cskordis/EFA-datorn-EFA-4-Computer/EFA-4 Ram Slim/BOM/EFA 4 Ram Slim Board.csv

Reference | Value | Footprint | Datasheet | Qty | DNP
C1,C2 | 100nF | Capacitor_THT:C_Disc_D3.0mm_W1.6mm_P2.50mm | ~ | 2
C3 | 47uF | Capacitor_THT:CP_Radial_D5.0mm_P2.50mm | ~ | 1
D1 | POWER | LED_THT:LED_D5.0mm | ~ | 1
J1 | ~ | LocalFP:EFAEdge |  | 1
J2 | Conn_01x03 | Connector_PinHeader_2.54mm:PinHeader_1x03_P2.54mm_Vertical | ~ | 1
R1 | 1K | Resistor_THT:R_Axial_DIN0207_L6.3mm_D2.5mm_P7.62mm_Horizontal | ~ | 1
U1 | 6164/6116 | Package_DIP:DIP-28_W15.24mm | https://www.farnell.com/datasheets/2159.pdf | 1
U2 | 74HC174 | Package_DIP:DIP-16_W7.62mm | http://www.ti.com/lit/gpn/sn74LS174 | 1
U3 | 6164 Slim | Package_DIP:DIP-28_W7.62mm_Socket | https://www.farnell.com/datasheets/2159.pdf | 1
