cskordis/EFA-datorn-EFA-4-Computer/EFA-4 Ram 32K/BOM/EFA 4 Ram 32K Board.csv

Reference | Value | Footprint | Datasheet | Qty | DNP
C1,C2 | 100nF | Capacitor_THT:C_Disc_D3.0mm_W1.6mm_P2.50mm | ~ | 2
C3 | 47uF | Capacitor_THT:CP_Radial_D5.0mm_P2.50mm | ~ | 1
C4 | 22pF | Capacitor_THT:C_Disc_D3.0mm_W1.6mm_P2.50mm | ~ | 1
D1 | POWER | LED_THT:LED_D5.0mm | ~ | 1
J1 | ~ | LocalFP:EFAEdge |  | 1
R1 | 1K | Resistor_THT:R_Axial_DIN0207_L6.3mm_D2.5mm_P7.62mm_Horizontal | ~ | 1
R2 | 22K | Resistor_THT:R_Axial_DIN0207_L6.3mm_D2.5mm_P7.62mm_Horizontal | ~ | 1
U1 | 74LS573 | Package_DIP:DIP-20_W7.62mm | 74xx/74hc573.pdf | 1
U2 | HM62256BLP | Package_DIP:DIP-28_W15.24mm | https://web.mit.edu/6.115/www/document/62256.pdf | 1
