cskordis/EFA-datorn-EFA-4-Computer/EFA-4 Auto Keyer/Images/EFA 4 AutoKeyer Component Side.jpg

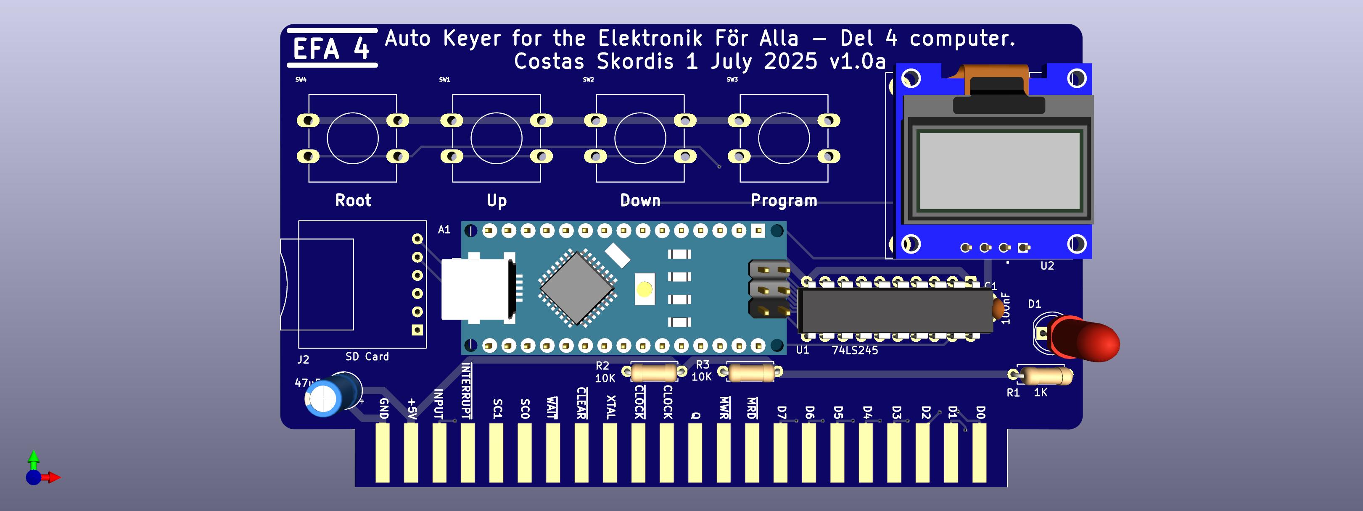
EFA-4 Auto Keyer/Images/EFA 4 AutoKeyer Component Side.jpg
