cskordis/EFA-datorn-EFA-4-Computer/EFA-4 CPU/Images/EFA 4 Component Side.jpg

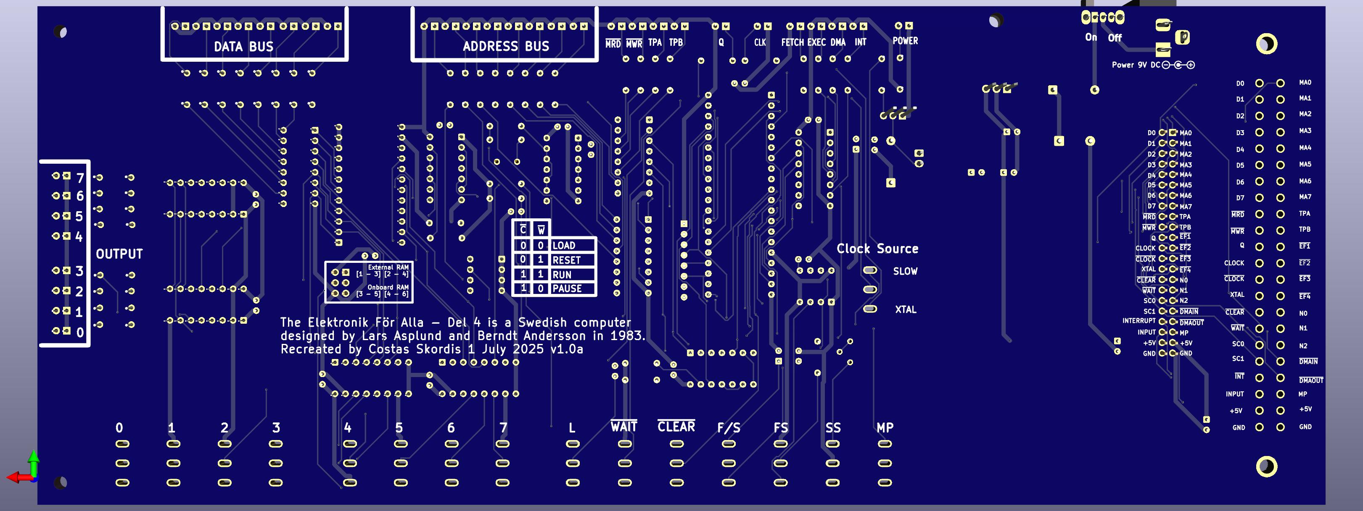
EFA-4 CPU/Images/EFA 4 Component Side.jpg
