cskordis/EFA-datorn-EFA-4-Computer/EFA-4 Hex Display Board/Images/EFA 4 Hex Display Board Component Side.jpg

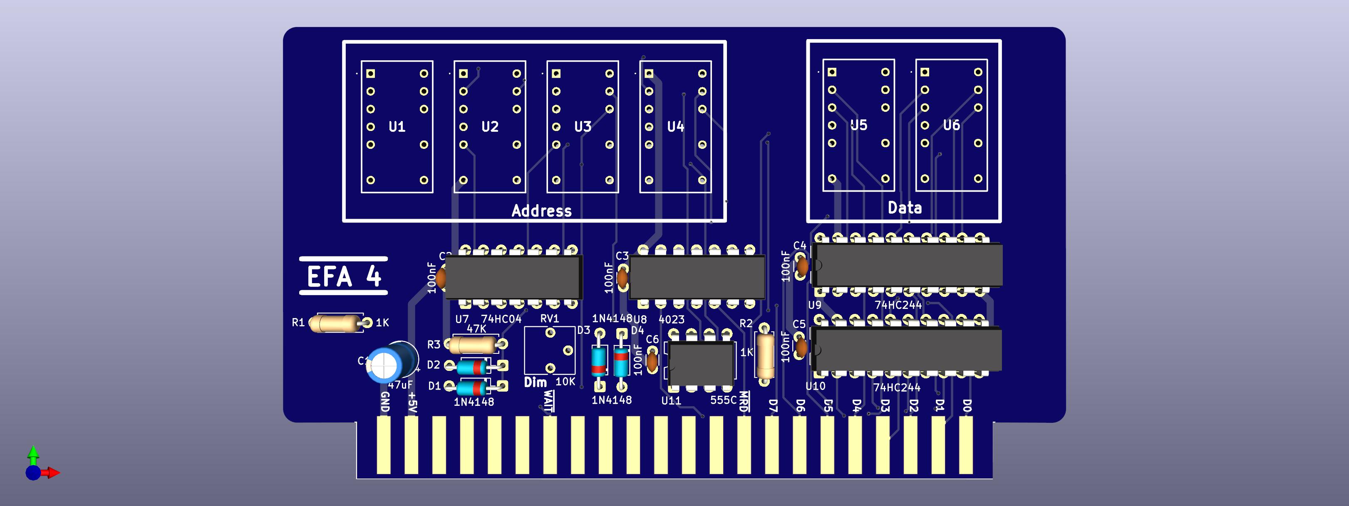
EFA-4 Hex Display Board/Images/EFA 4 Hex Display Board Component Side.jpg
