cskordis/EFA-datorn-EFA-4-Computer/EFA-4 Keypad Input/Images/EFA 4 Keypad Component Side.jpg

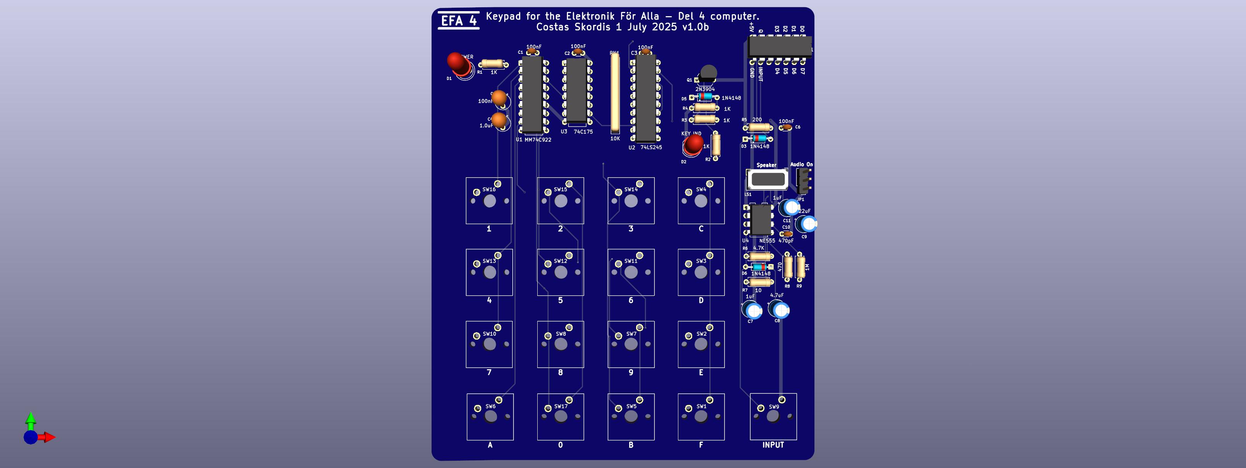
EFA-4 Keypad Input/Images/EFA 4 Keypad Component Side.jpg
