cskordis/EFA-datorn-EFA-4-Computer/EFA-4 Protoboard/Images/EFA 4 Blank Board Component Side.jpg

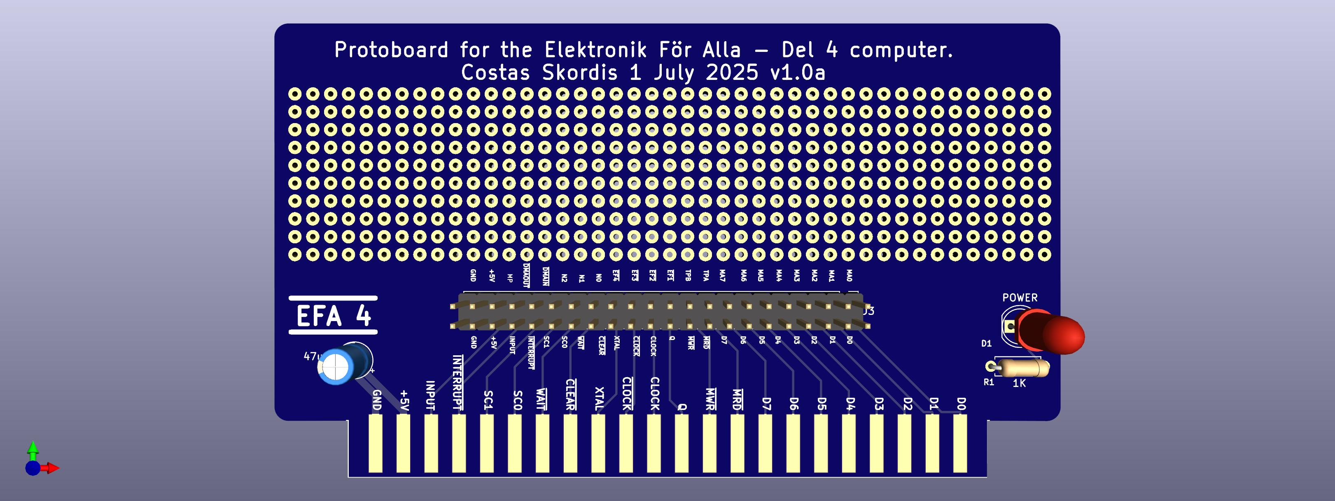
EFA-4 Protoboard/Images/EFA 4 Blank Board Component Side.jpg
