cskordis/EFA-datorn-EFA-4-Computer/EFA-4 Ram 32K/Images/EFA 4 Ram 32K Board Component Side.jpg

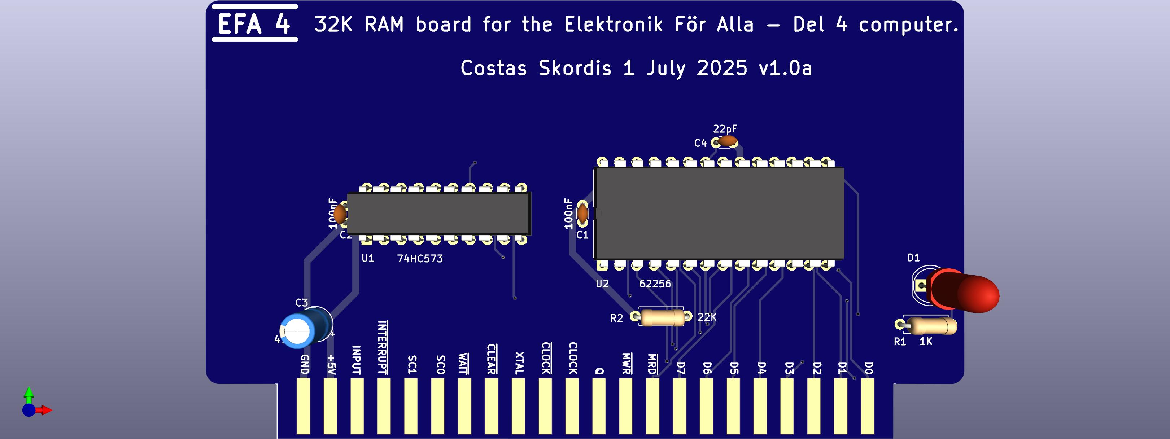
EFA-4 Ram 32K/Images/EFA 4 Ram 32K Board Component Side.jpg
