cskordis/EFA-datorn-EFA-4-Computer/EFA-4 Ram Rom 32K/Images/EFA 4 Ram Rom 32K Board Component Side.jpg

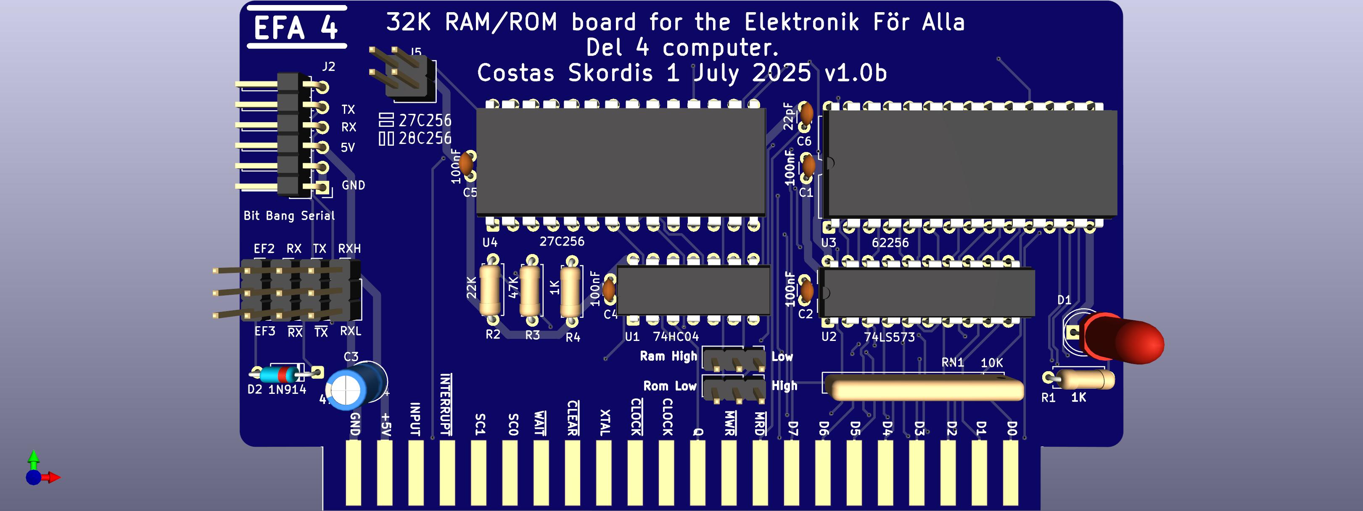
EFA-4 Ram Rom 32K/Images/EFA 4 Ram Rom 32K Board Component Side.jpg
