cskordis/EFA-datorn-EFA-4-Computer/EFA-4 Ram Slim/Images/EFA 4 Ram Slim Board Component Side.jpg

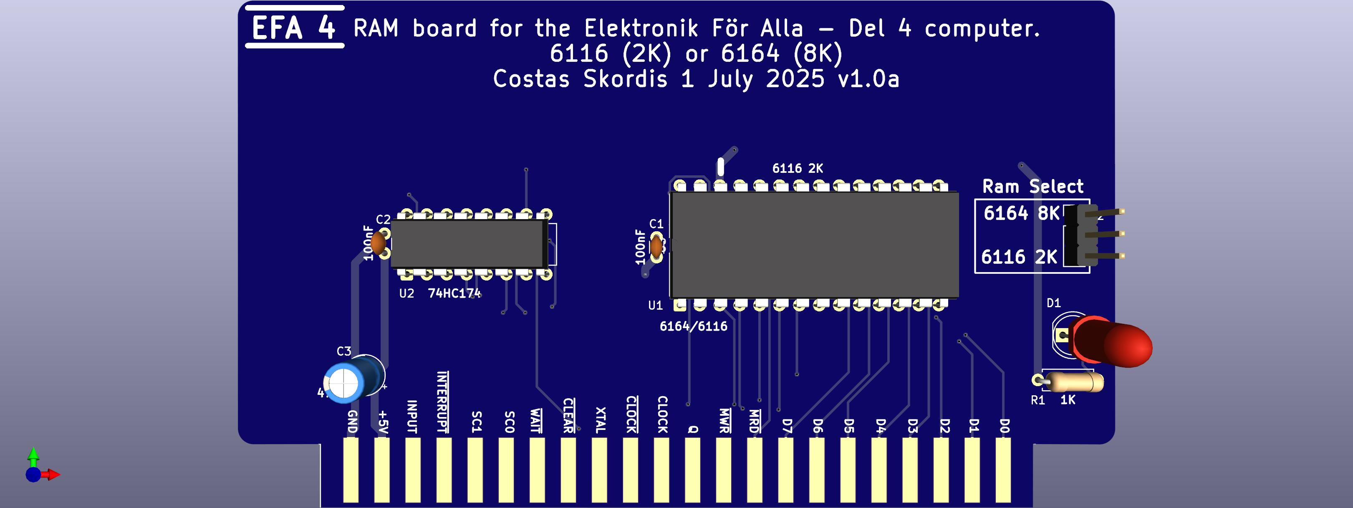
EFA-4 Ram Slim/Images/EFA 4 Ram Slim Board Component Side.jpg
