cskordis/EFA-datorn-EFA-4-Computer/EFA-4 Backplane Board/Images/EFA 4 Backplane Board Solder Side.jpg

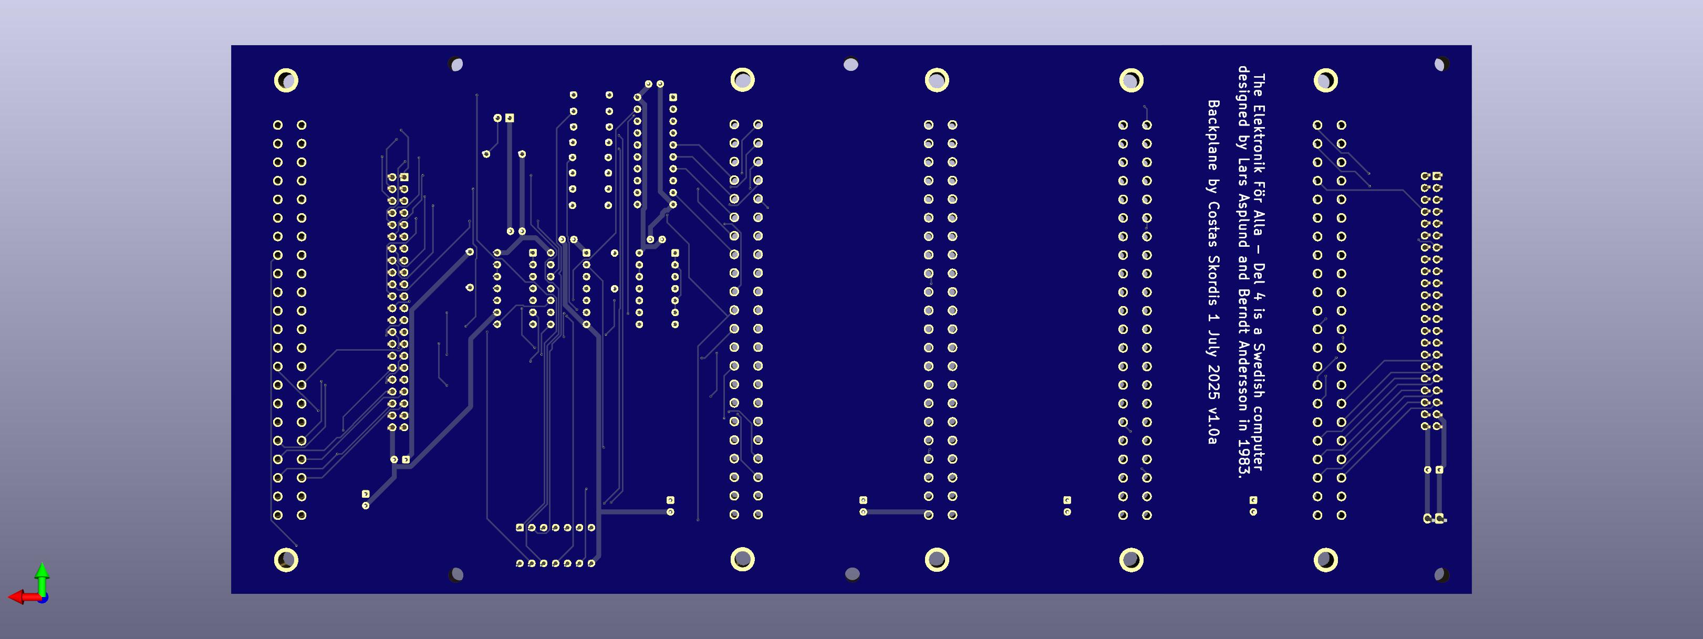
EFA-4 Backplane Board/Images/EFA 4 Backplane Board Solder Side.jpg
