cskordis/EFA-datorn-EFA-4-Computer/EFA-4 Hex Display Board/Images/EFA 4 Hex Display Board Solder Side.jpg

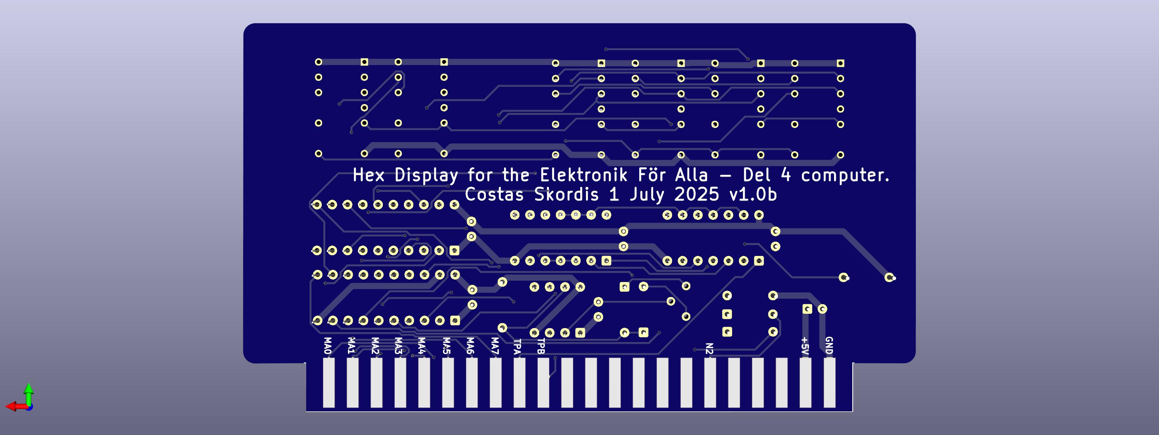
EFA-4 Hex Display Board/Images/EFA 4 Hex Display Board Solder Side.jpg
