cskordis/EFA-datorn-EFA-4-Computer/EFA-4 Pixie/Images/EFA 4 Pixie Board Solder Side.jpg

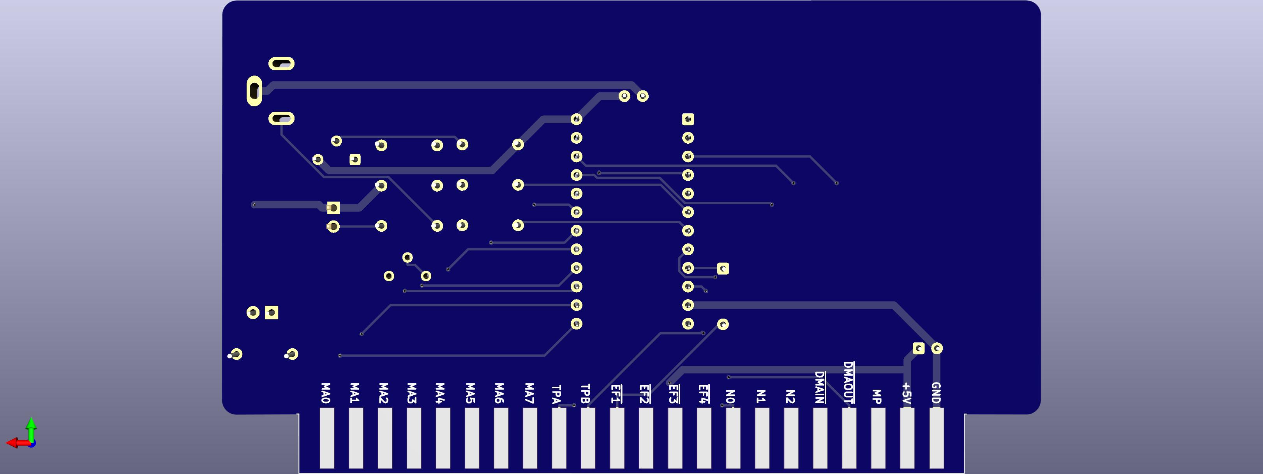
EFA-4 Pixie/Images/EFA 4 Pixie Board Solder Side.jpg
