cskordis/EFA-datorn-EFA-4-Computer/EFA-4 Ram Rom 32K/Images/EFA 4 Ram Rom 32K Board Solder Side.jpg

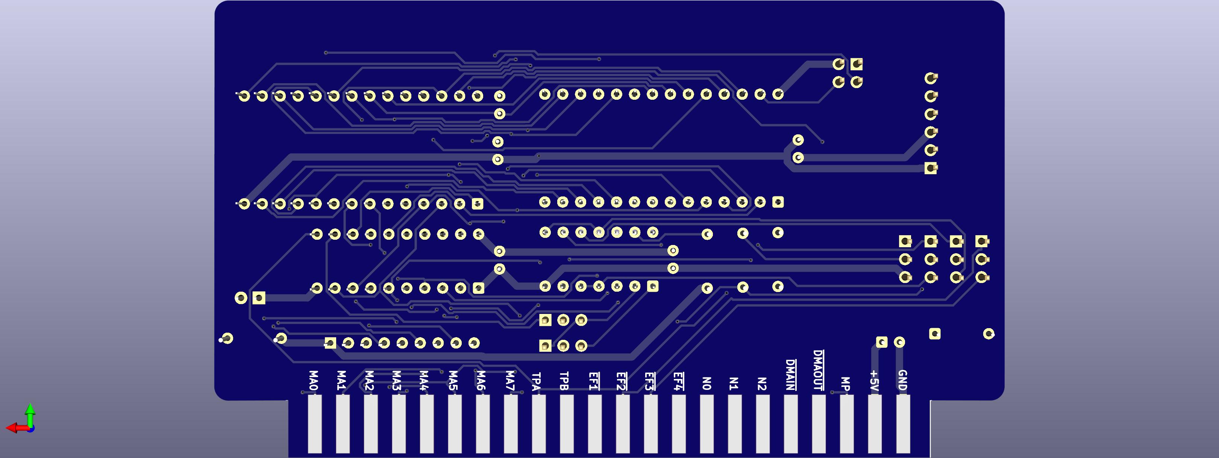
EFA-4 Ram Rom 32K/Images/EFA 4 Ram Rom 32K Board Solder Side.jpg
