cskordis/EFA-datorn-EFA-4-Computer/EFA-4 Ram/Images/EFA 4 Ram Board Solder Side.jpg

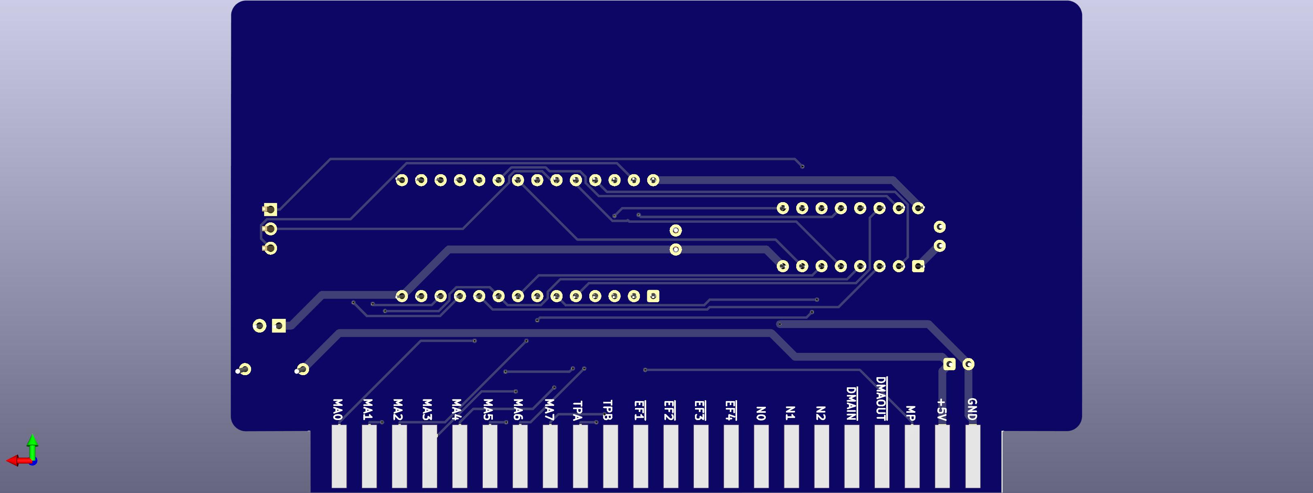
EFA-4 Ram/Images/EFA 4 Ram Board Solder Side.jpg
