cskordis/EFA-datorn-EFA-4-Computer/EFA-4 CPU/Schematic/EFA 4 Schematic.pdf

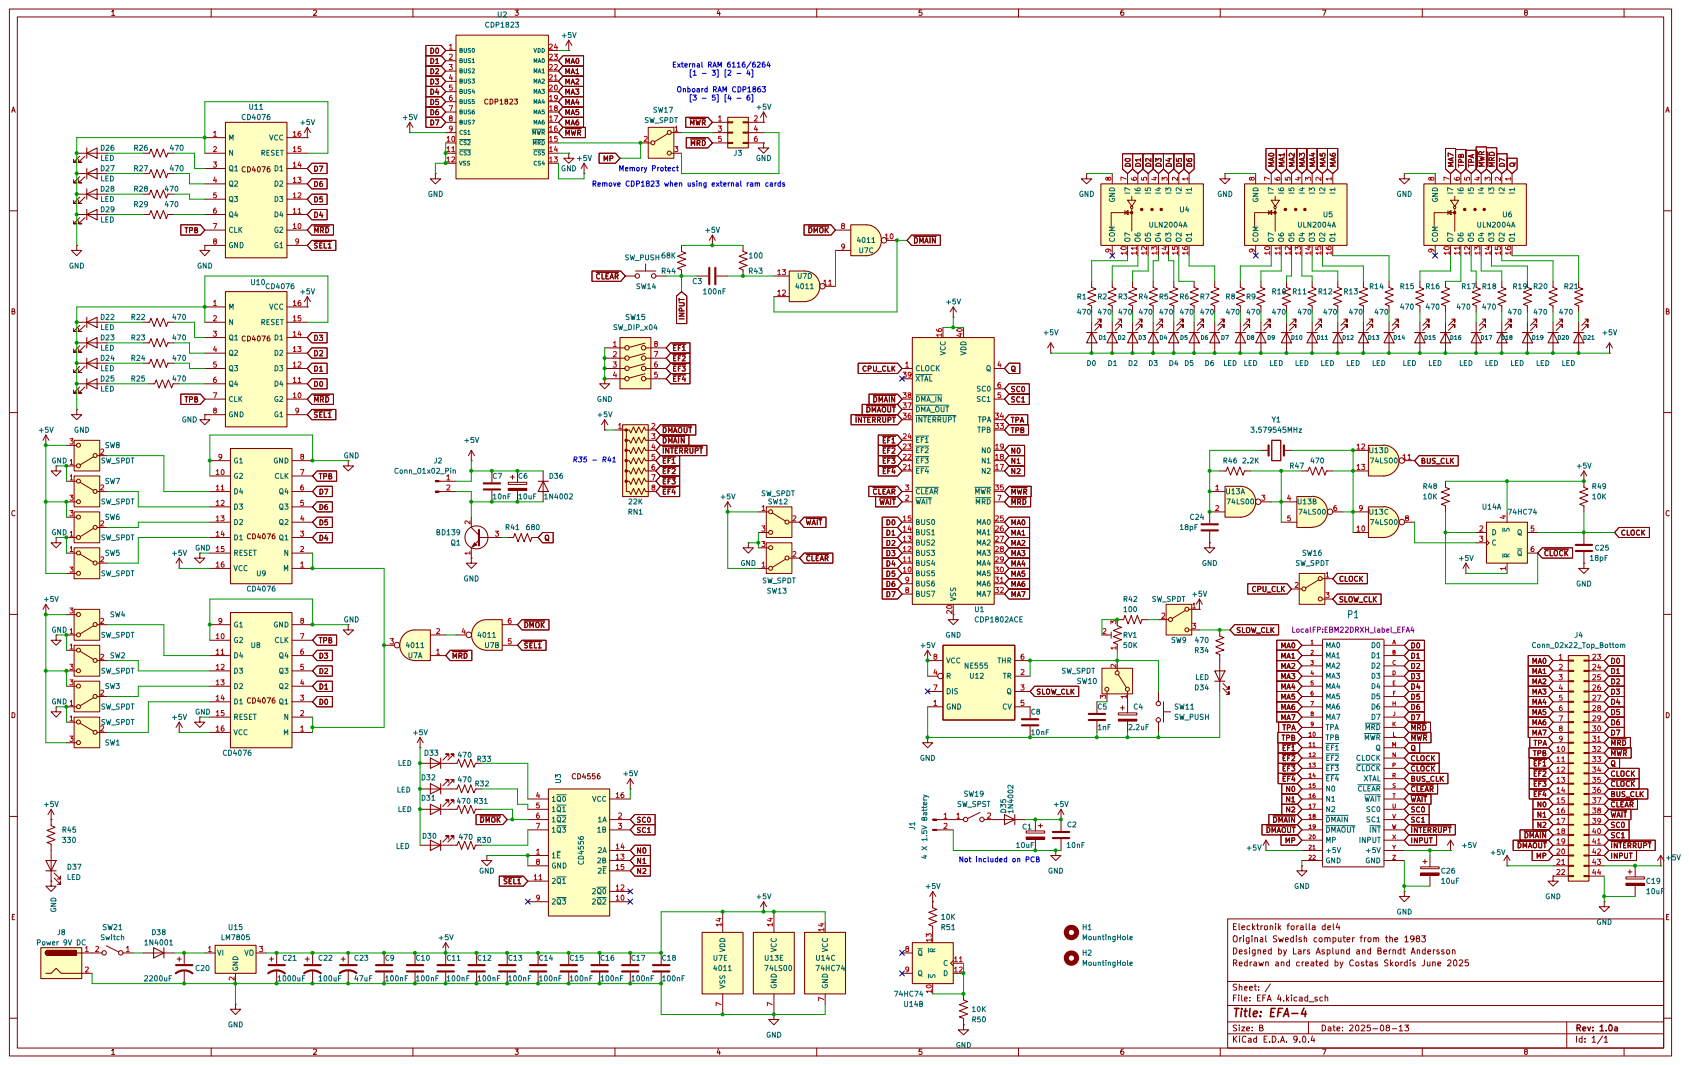
[picture p20: page 1]
