cskordis/EFA-datorn-EFA-4-Computer/EFA-4 Hex Display Board/Schematic/EFA 4 Hex Display Board Schematic.pdf

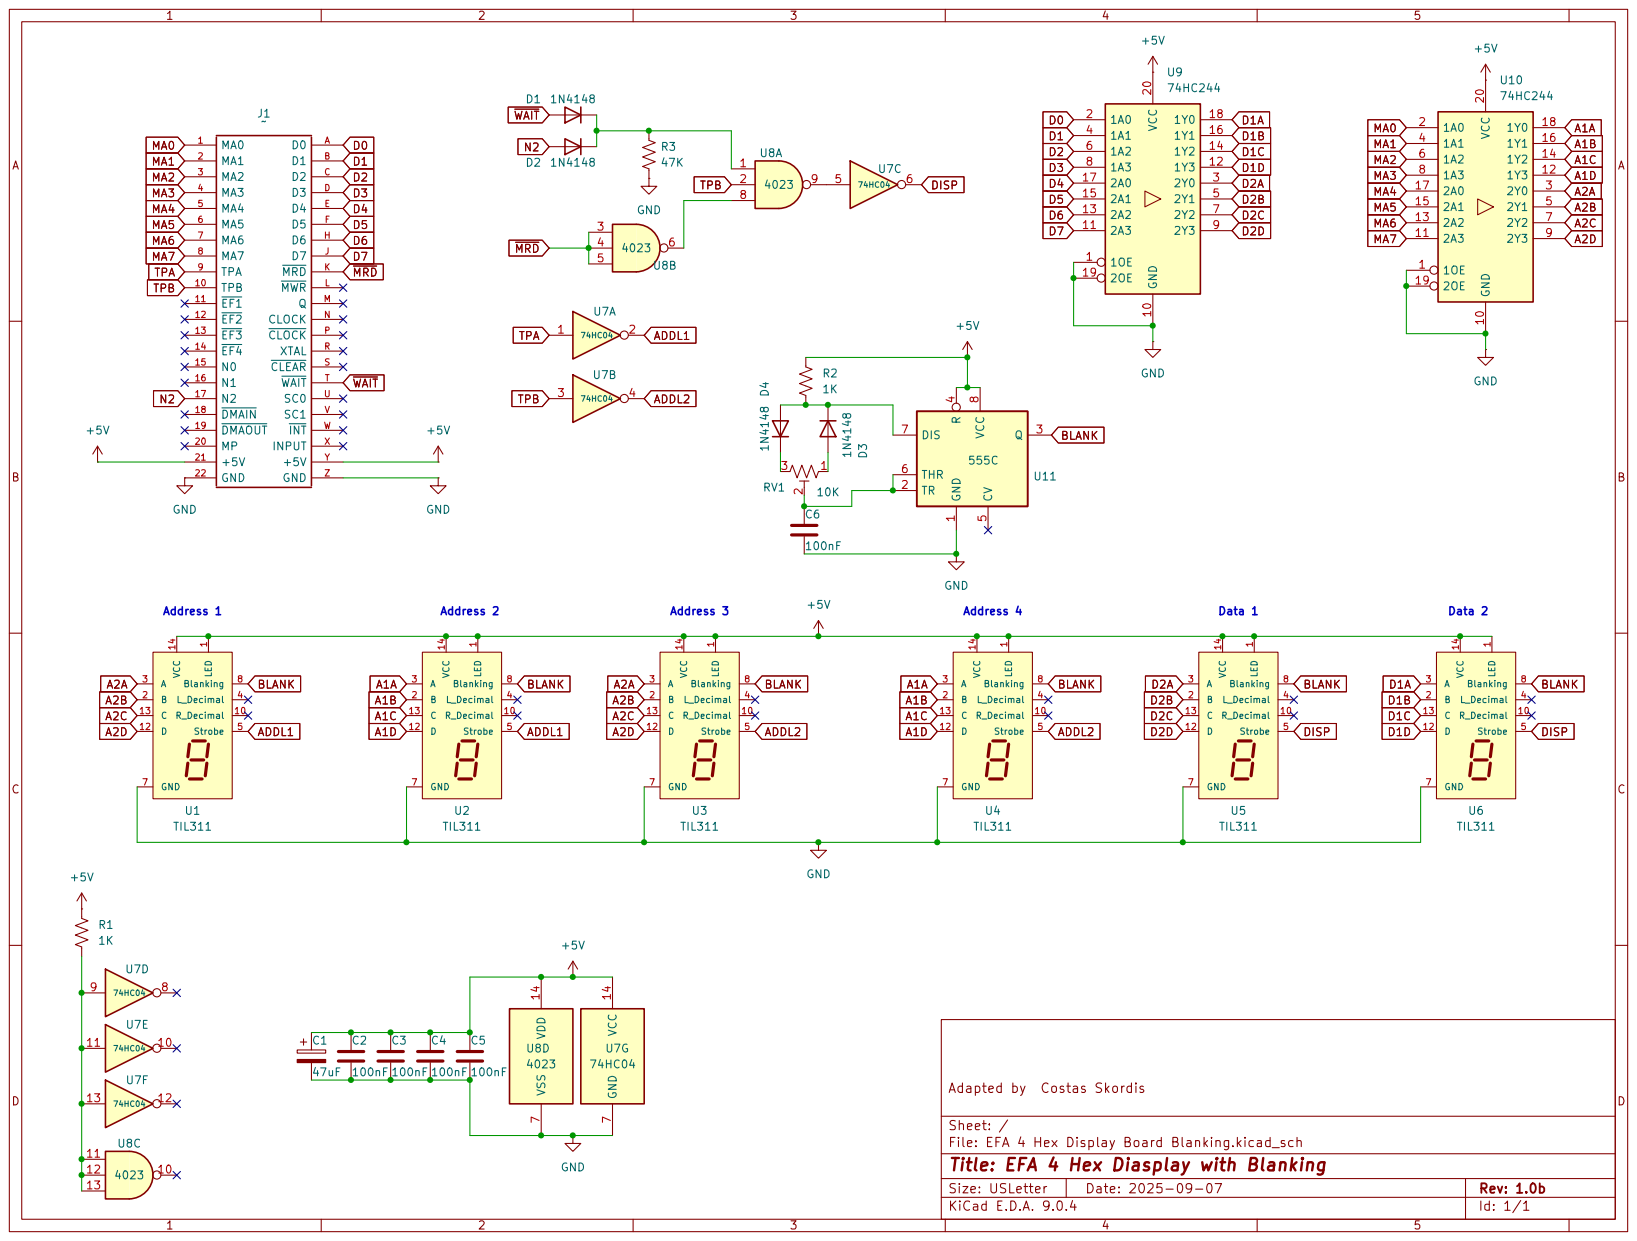
[picture p21: page 1]
