cskordis/EFA-datorn-EFA-4-Computer/EFA-4 Keypad Input/Schematic/EFA 4 Keypad Input Schematic.pdf

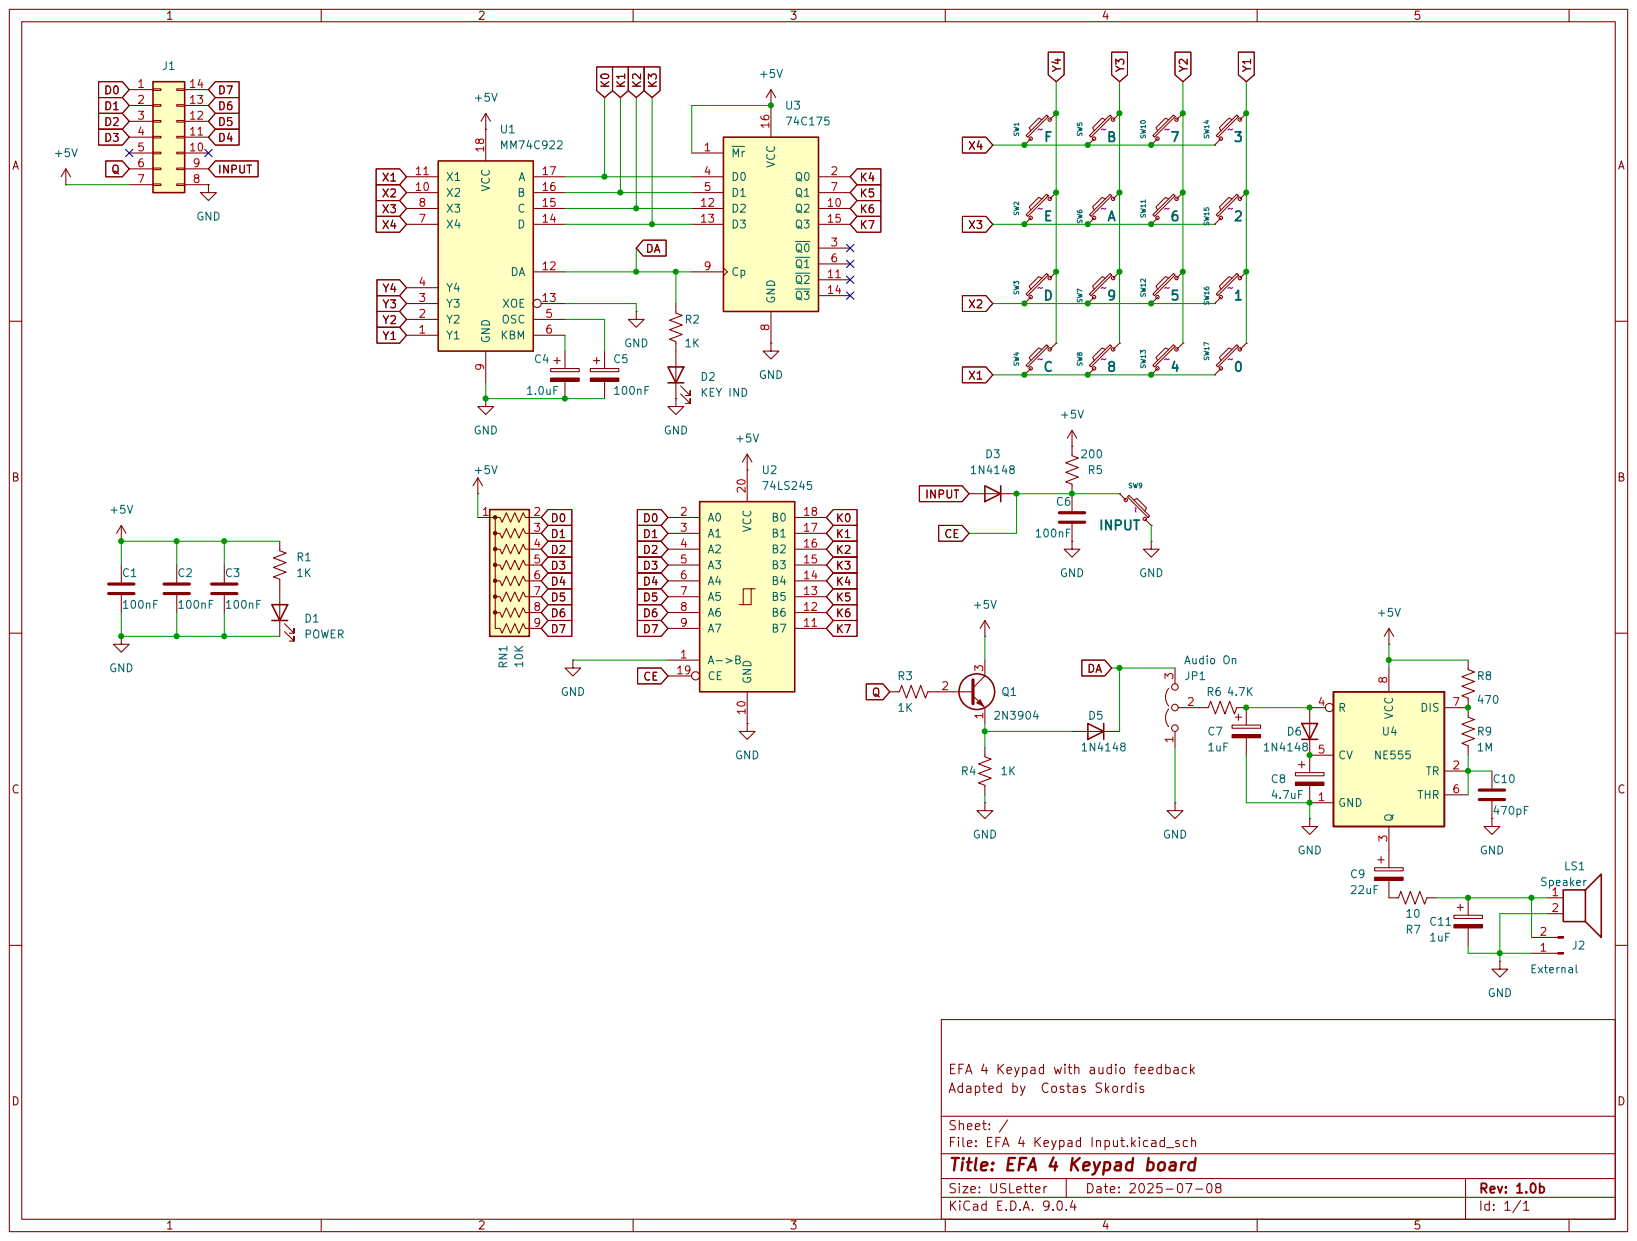
[picture p22: page 1]
