cskordis/EFA-datorn-EFA-4-Computer/EFA-4 Ram Rom 32K/Schematic/EFA 4 Ram Rom 32K Schematic.pdf

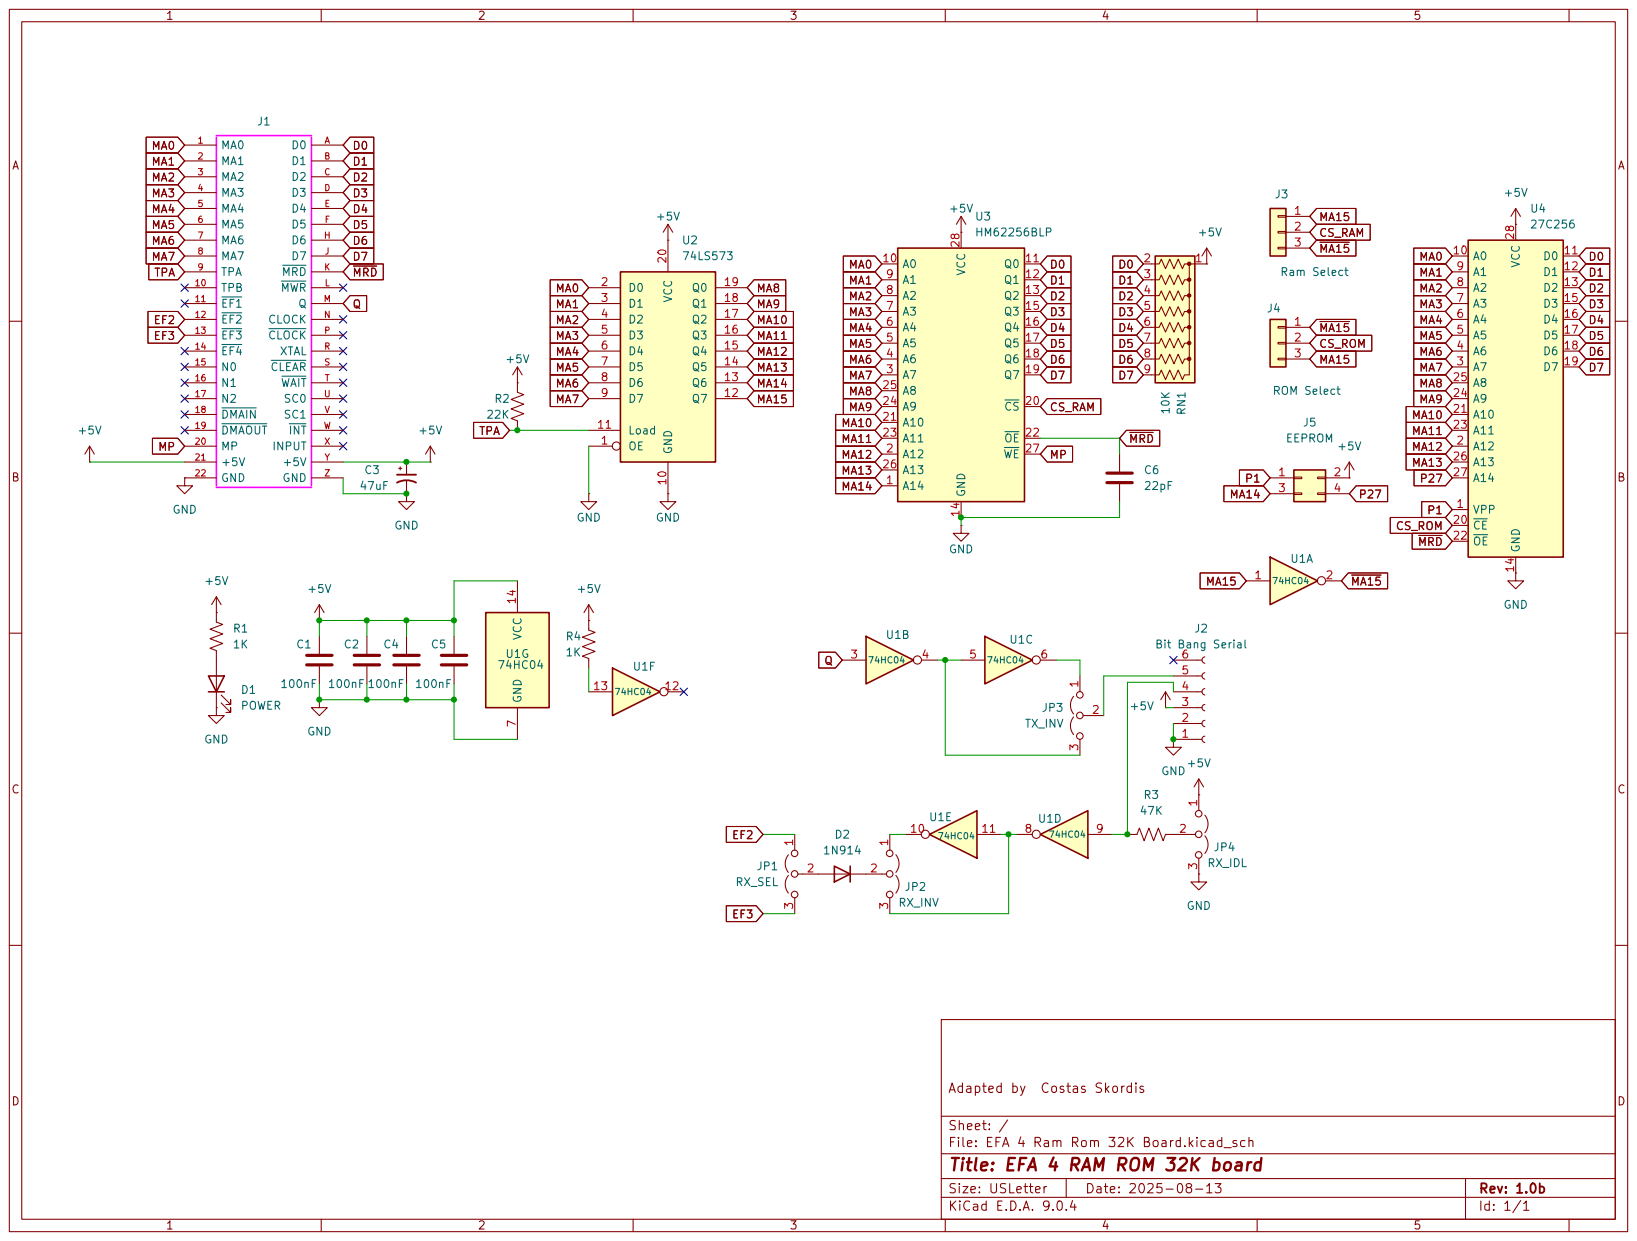
[picture p23: page 1]
