cskordis/EFA-datorn-EFA-4-Computer/EFA-4 Ram Slim/Schematic/EFA 4 Ram Slim Board Schematic.pdf

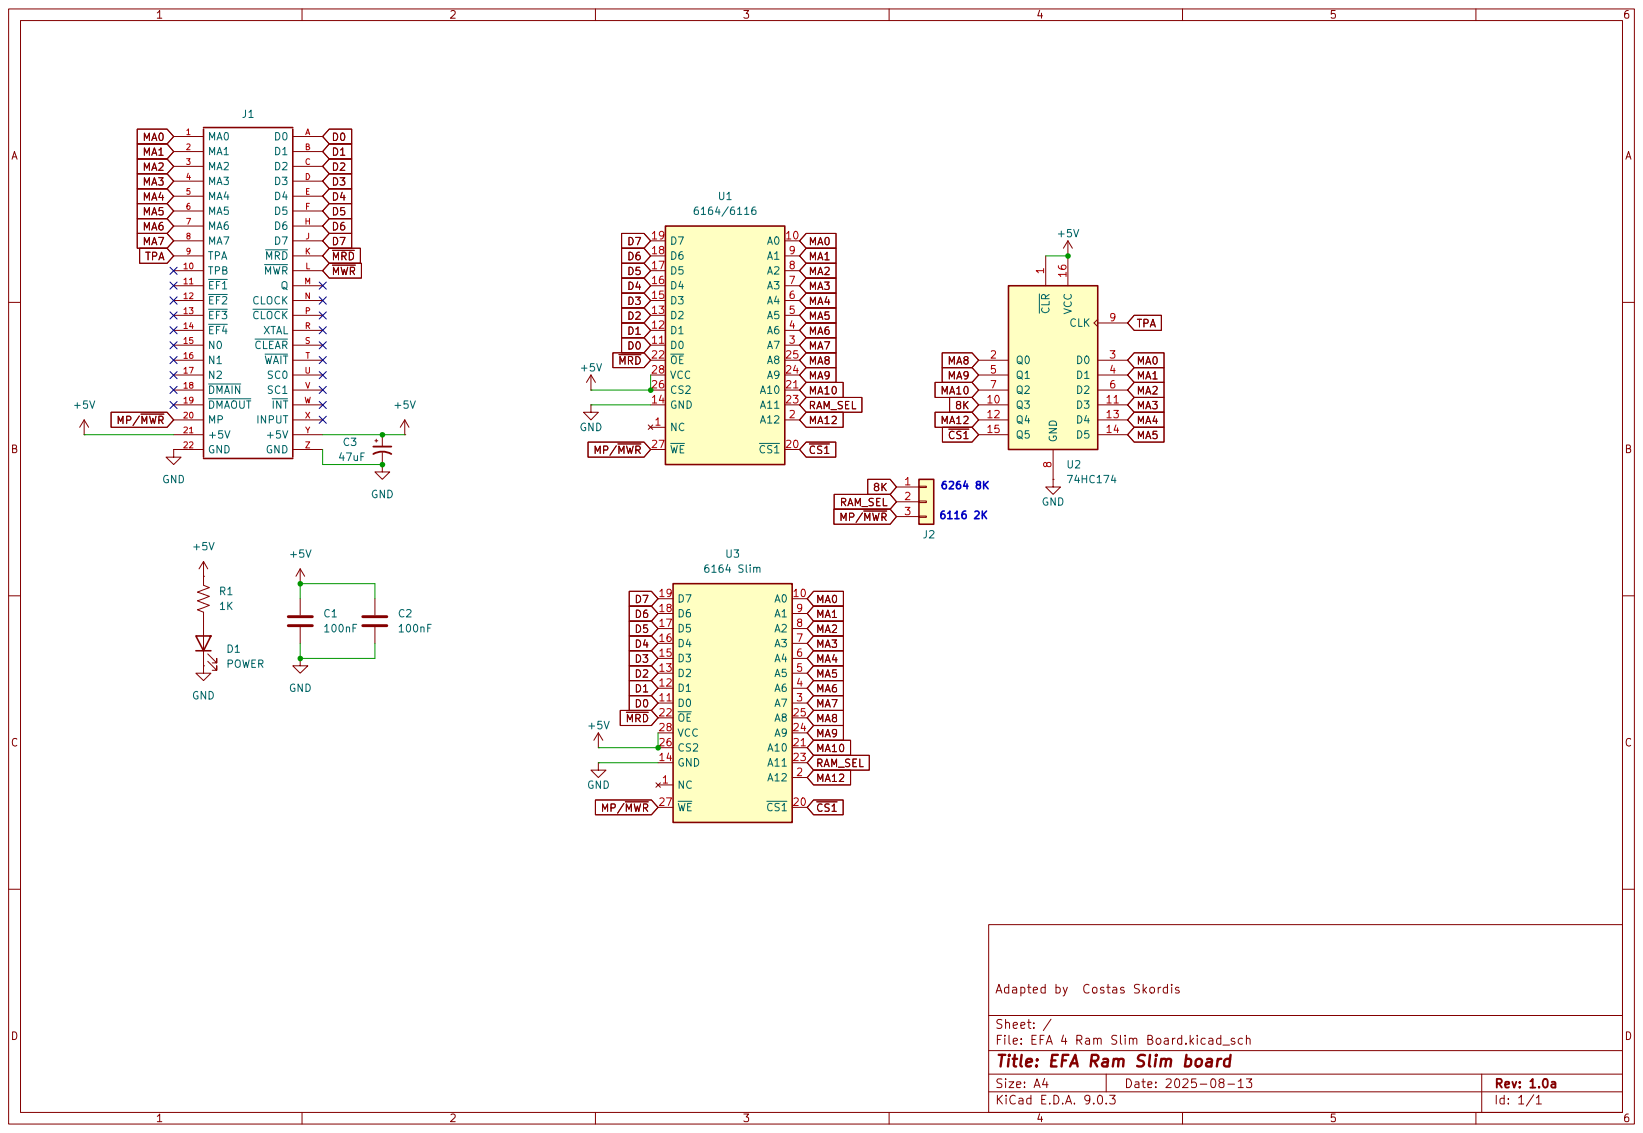
[picture p24: page 1]
