cskordis/EFA-datorn-EFA-4-Computer/EFA-4 Ram 32K/Schematic/EFA 4 RAM 32K Board Schematic.pdf

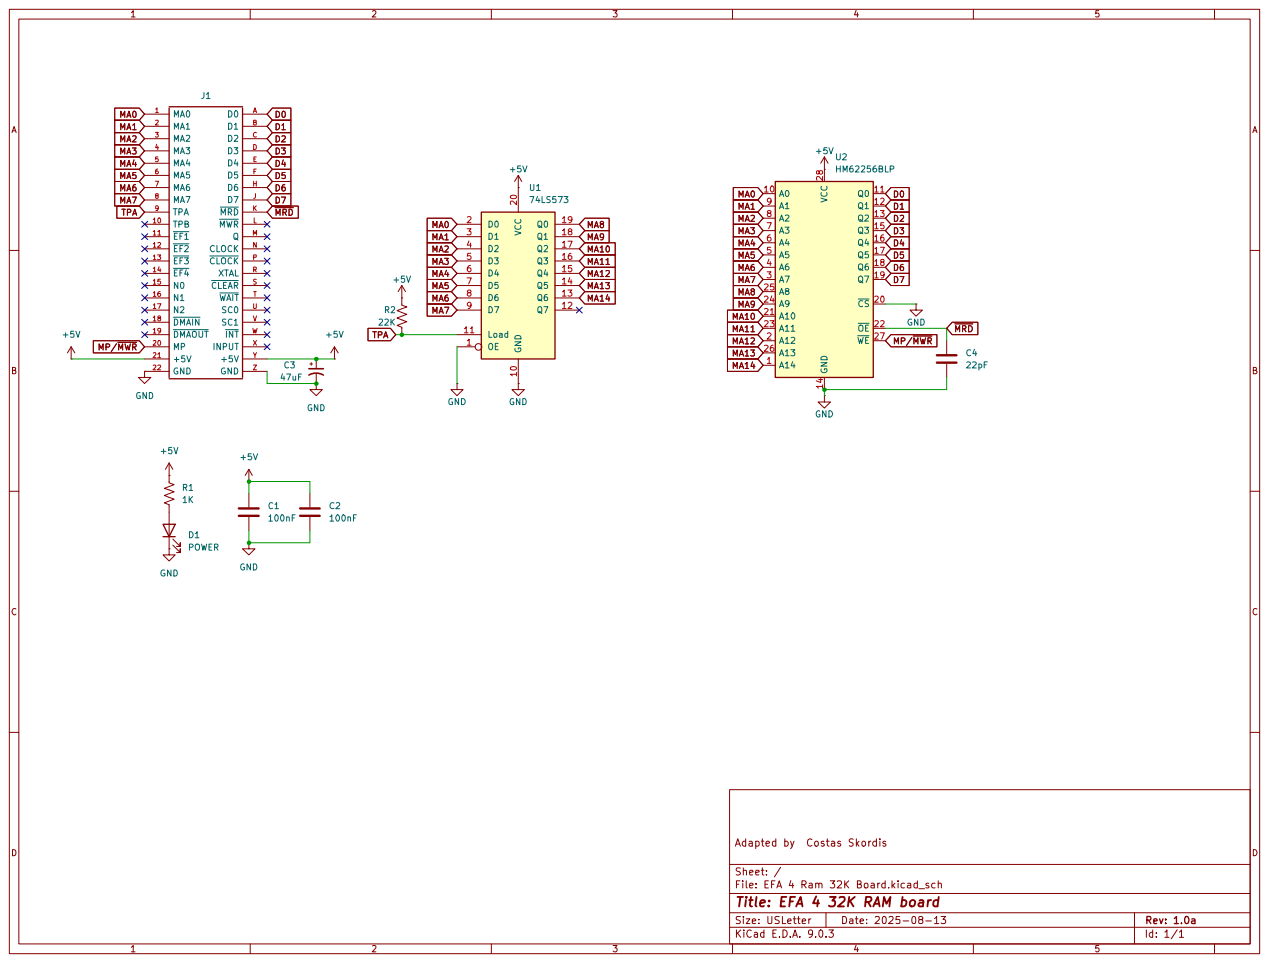
[picture p25: page 1]
