cskordis/EFA-datorn-EFA-4-Computer/EFA-4 Ram/Schematic/EFA 4 Ram Board Schematic.pdf

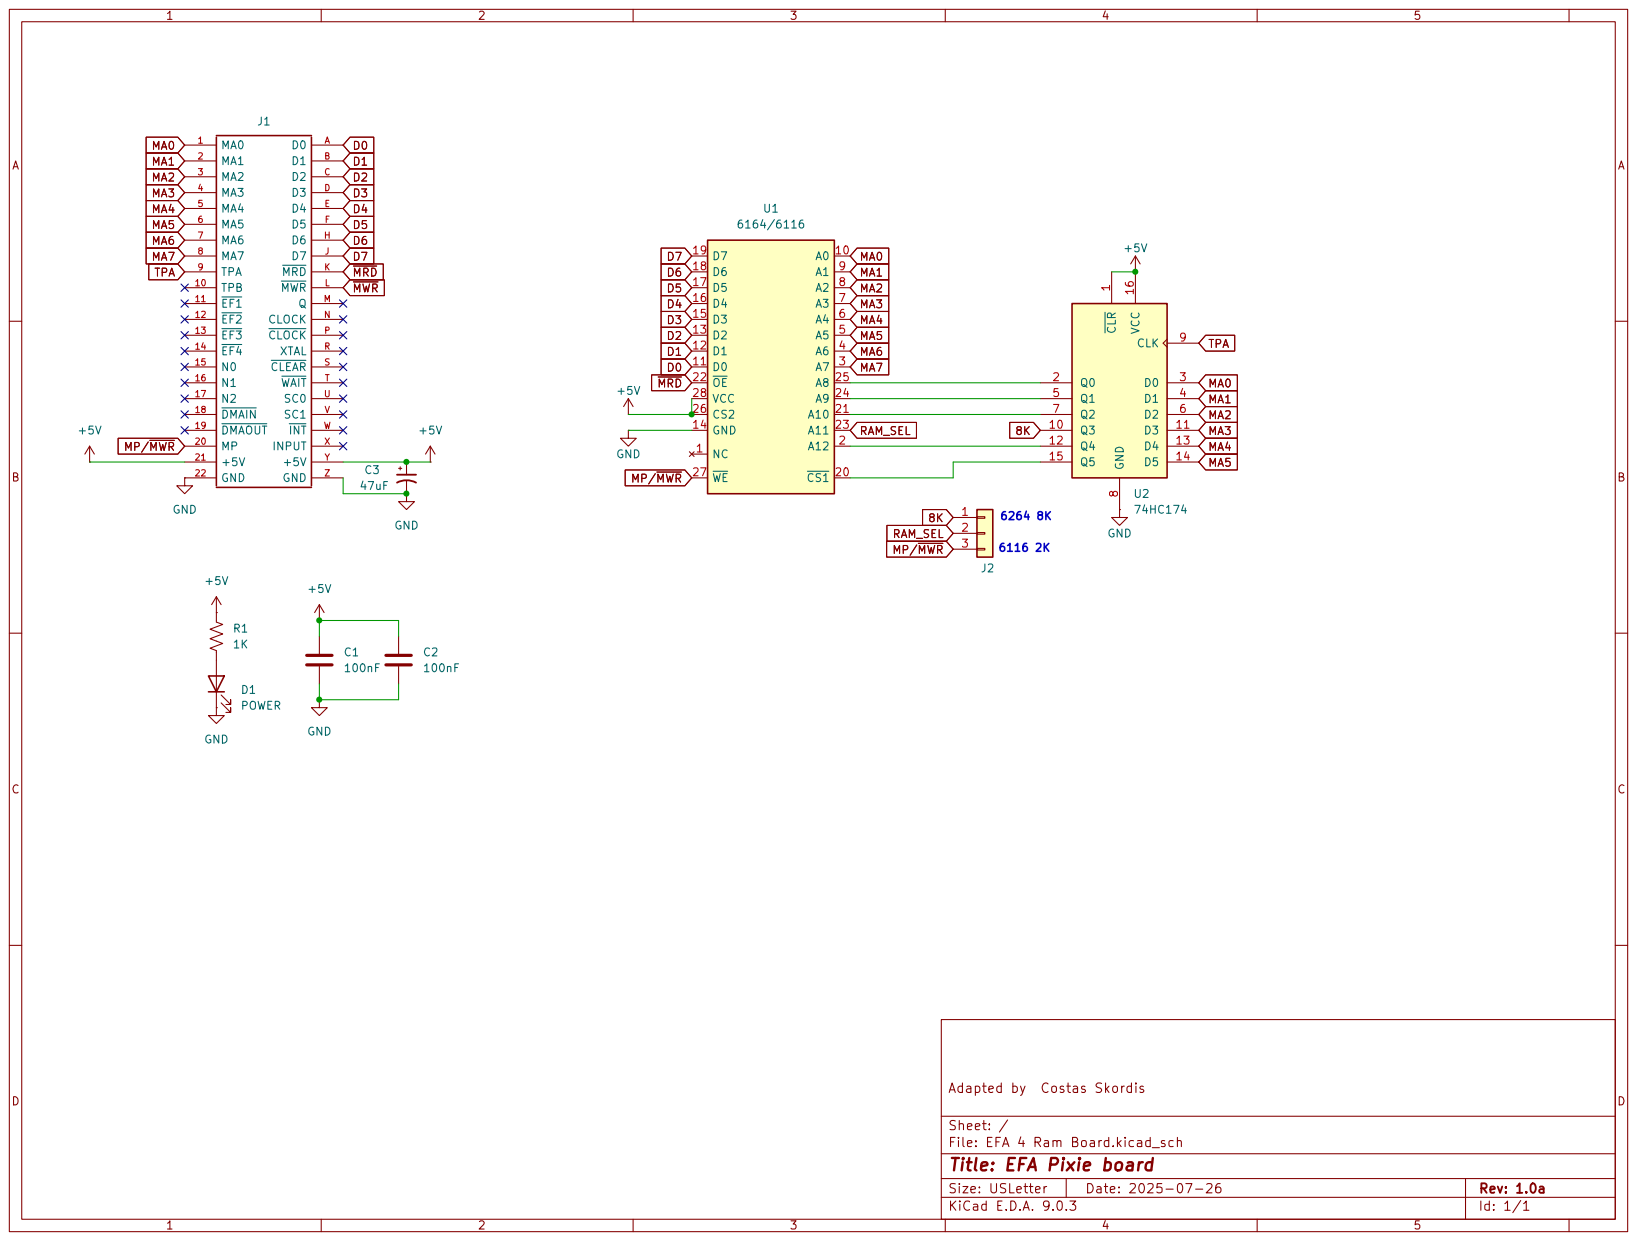
[picture p26: page 1]
