cskordis/EFA-datorn-EFA-4-Computer/EFA-4 Pixie/Schematic/EFA 4 Pixie Schematic.pdf

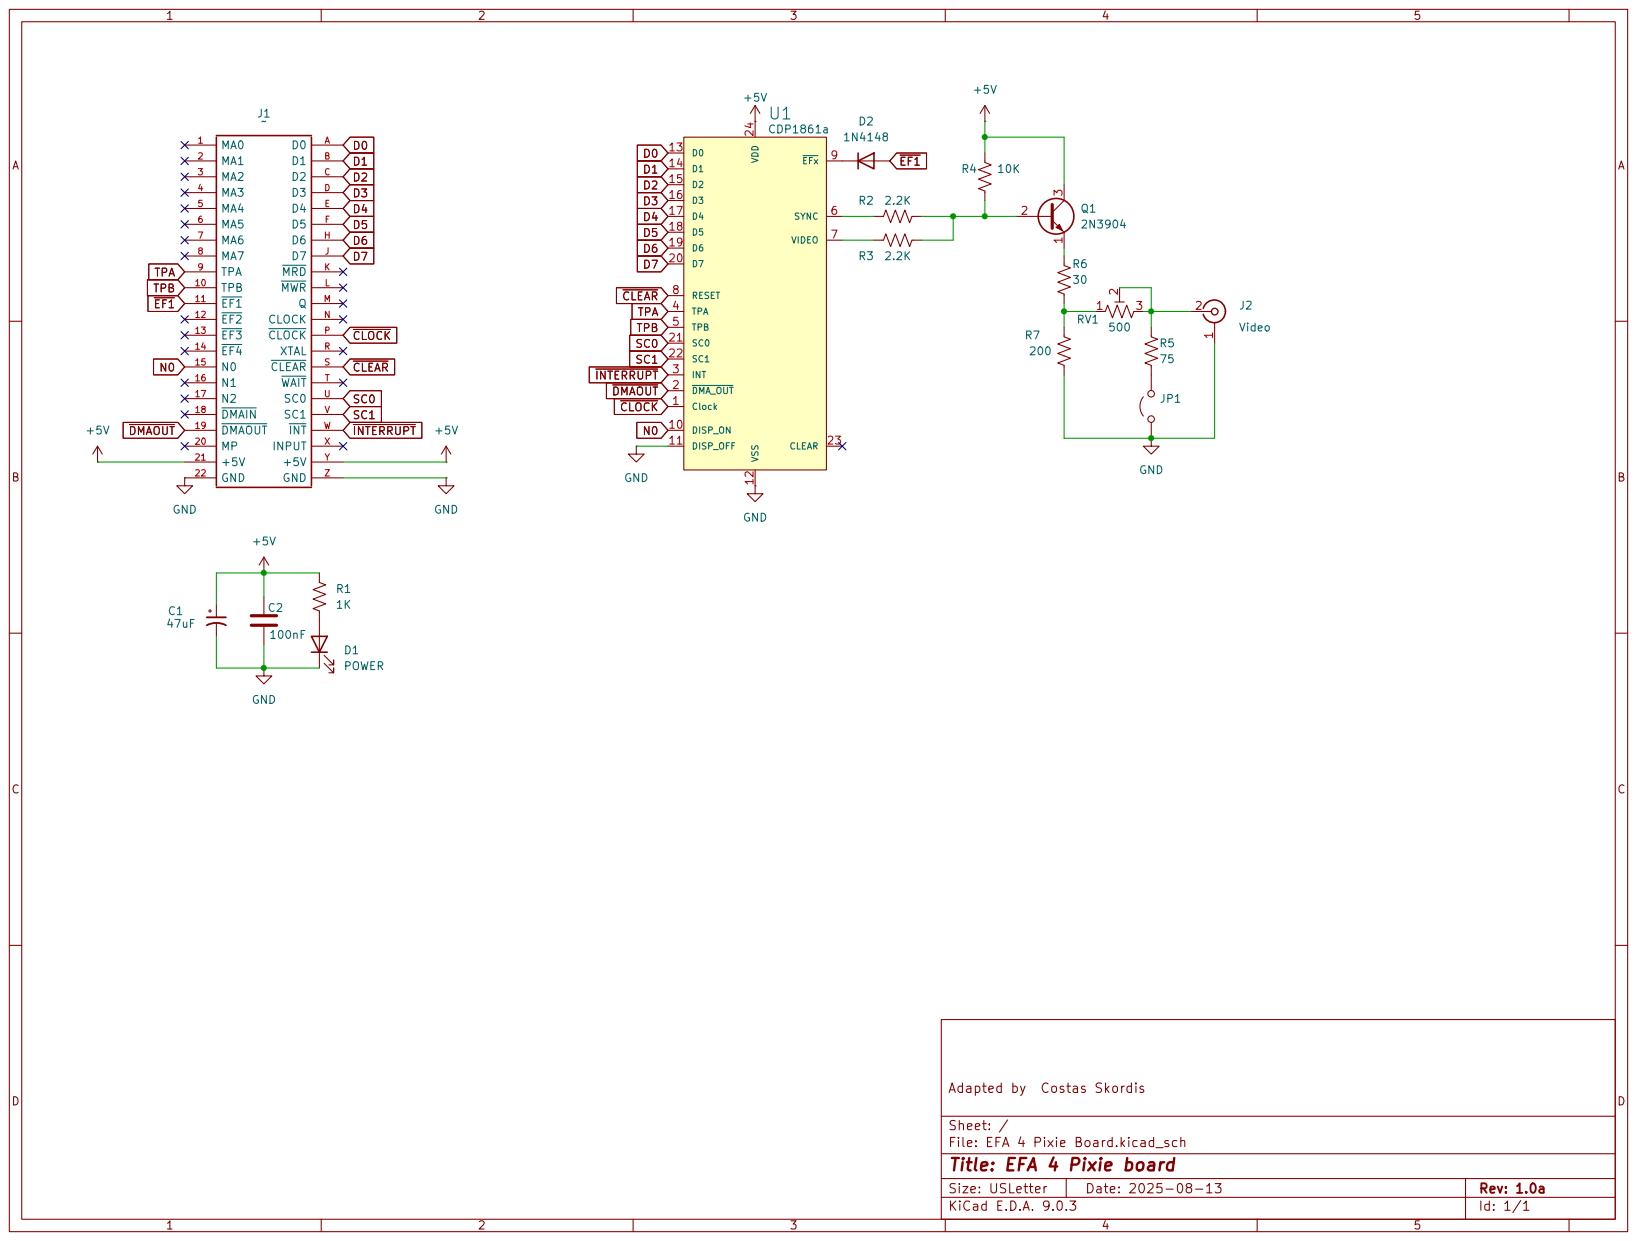
[picture p27: page 1]
