cskordis/EFA-datorn-EFA-4-Computer/EFA-4 Hex Display/Schematic/EFA 4 Hex Display Board Schematic.pdf

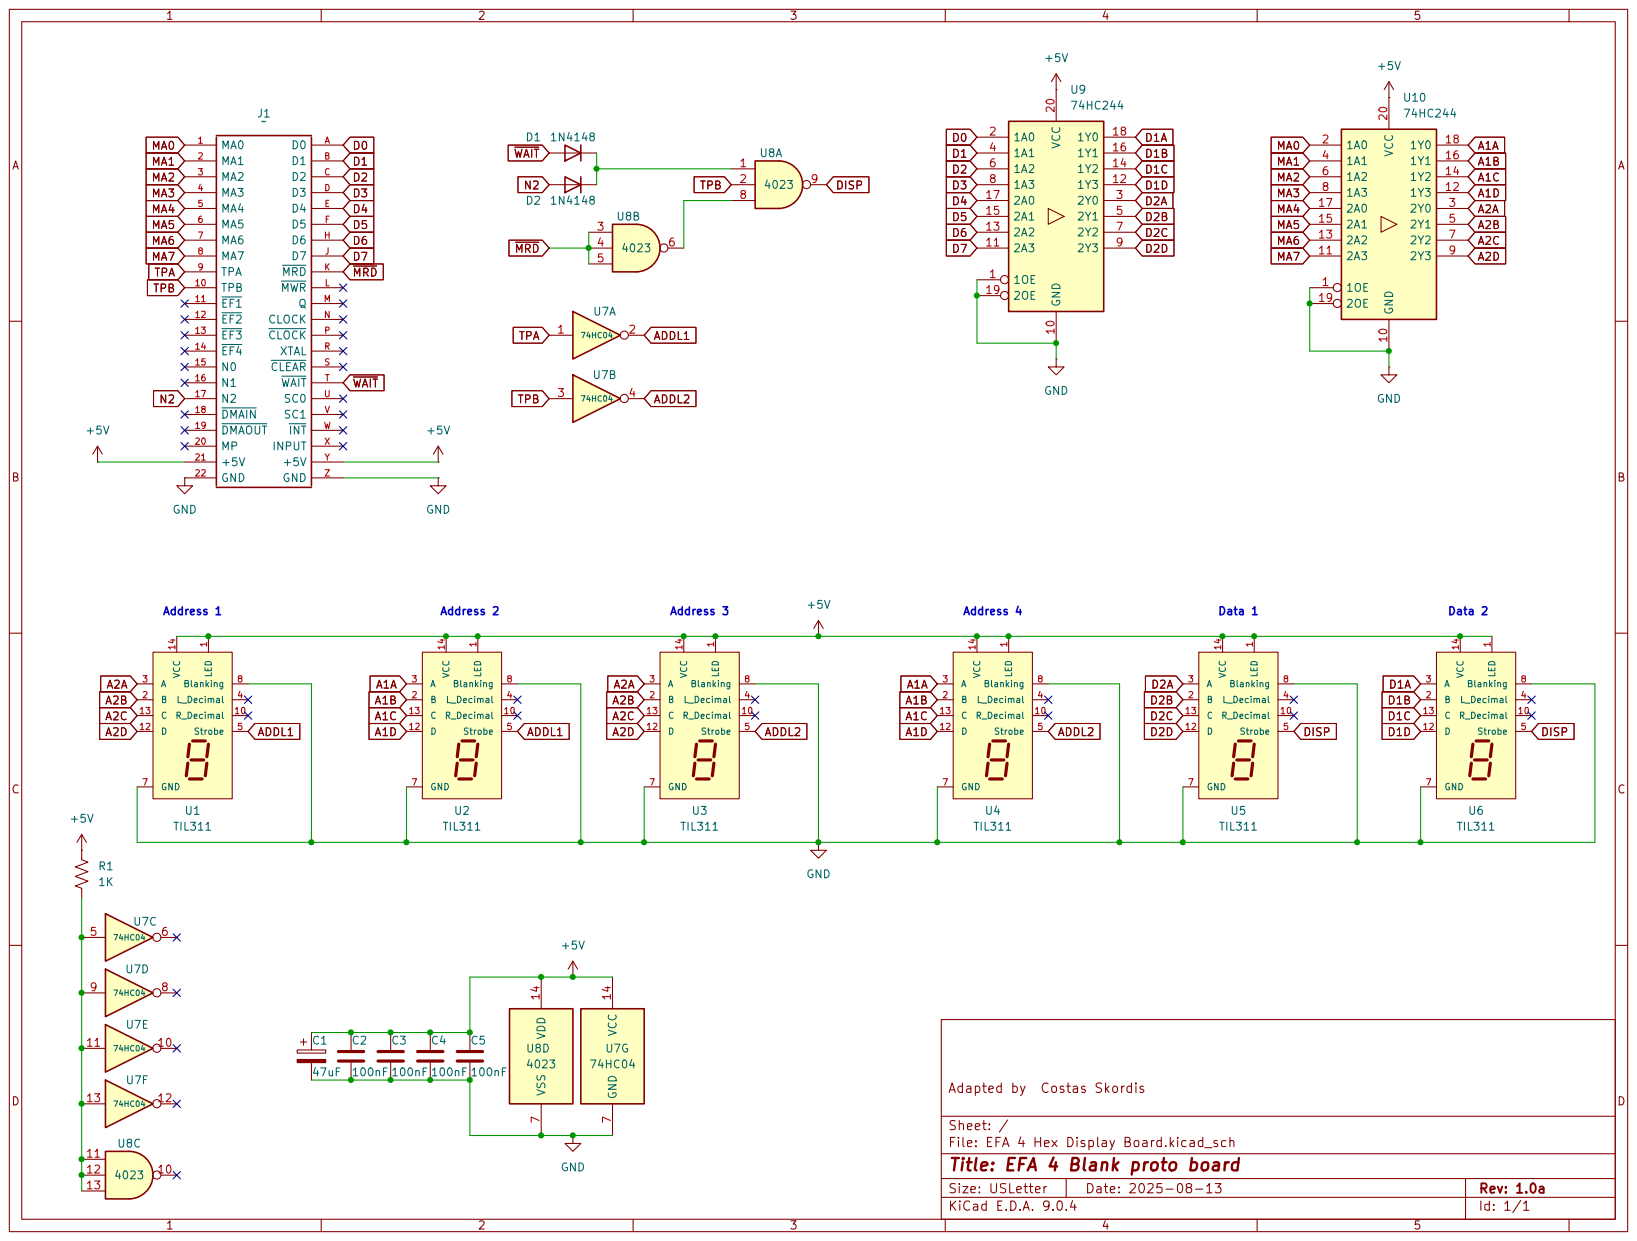
[picture p28: page 1]
