cskordis/EFA-datorn-EFA-4-Computer/EFA-4 Protoboard/Schematic/EFA 4 Blank Board Schematic.pdf

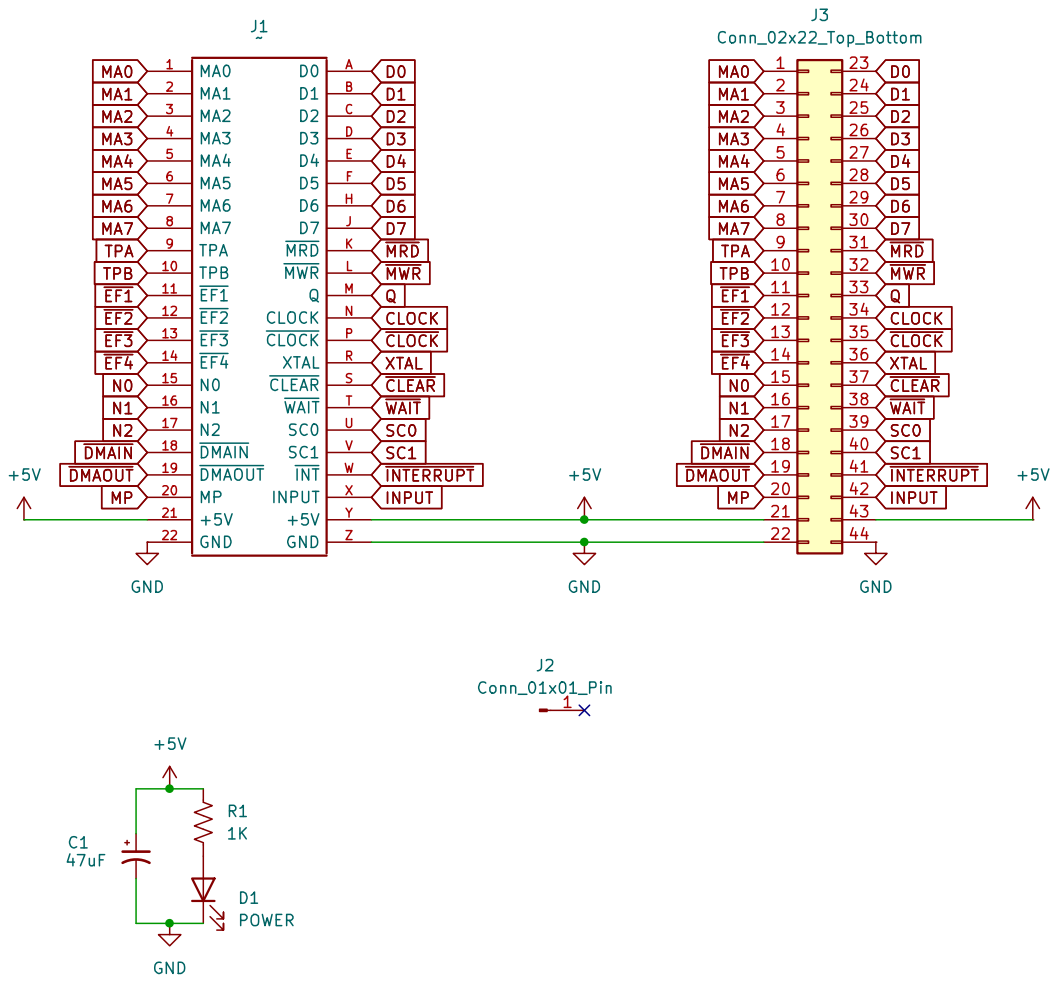
[picture p29: page 1]
