cskordis/EFA-datorn-EFA-4-Computer/EFA-4 Backplane Board/Schematic/EFA 4 Backplane Board.pdf

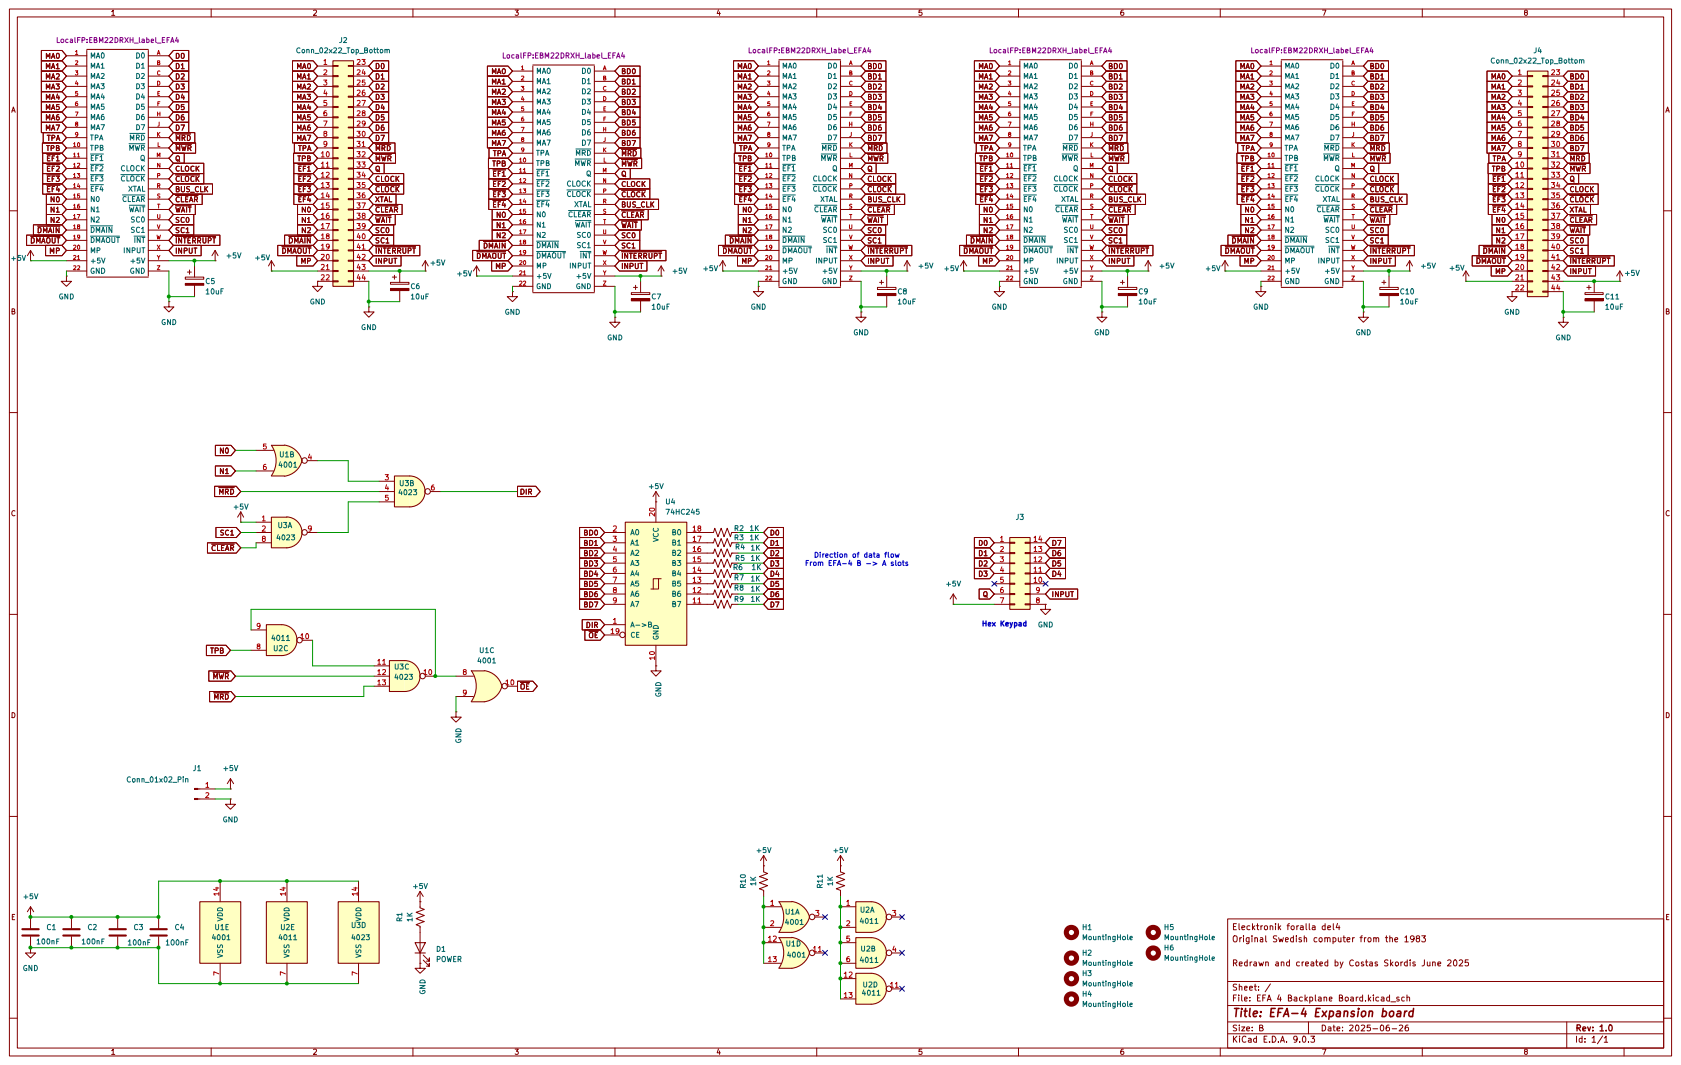
[picture p30: page 1]
