cskordis/EFA-datorn-EFA-4-Computer/EFA-4 Auto Keyer/Schematic/EFA 4 AutoKeyer Schematic.pdf

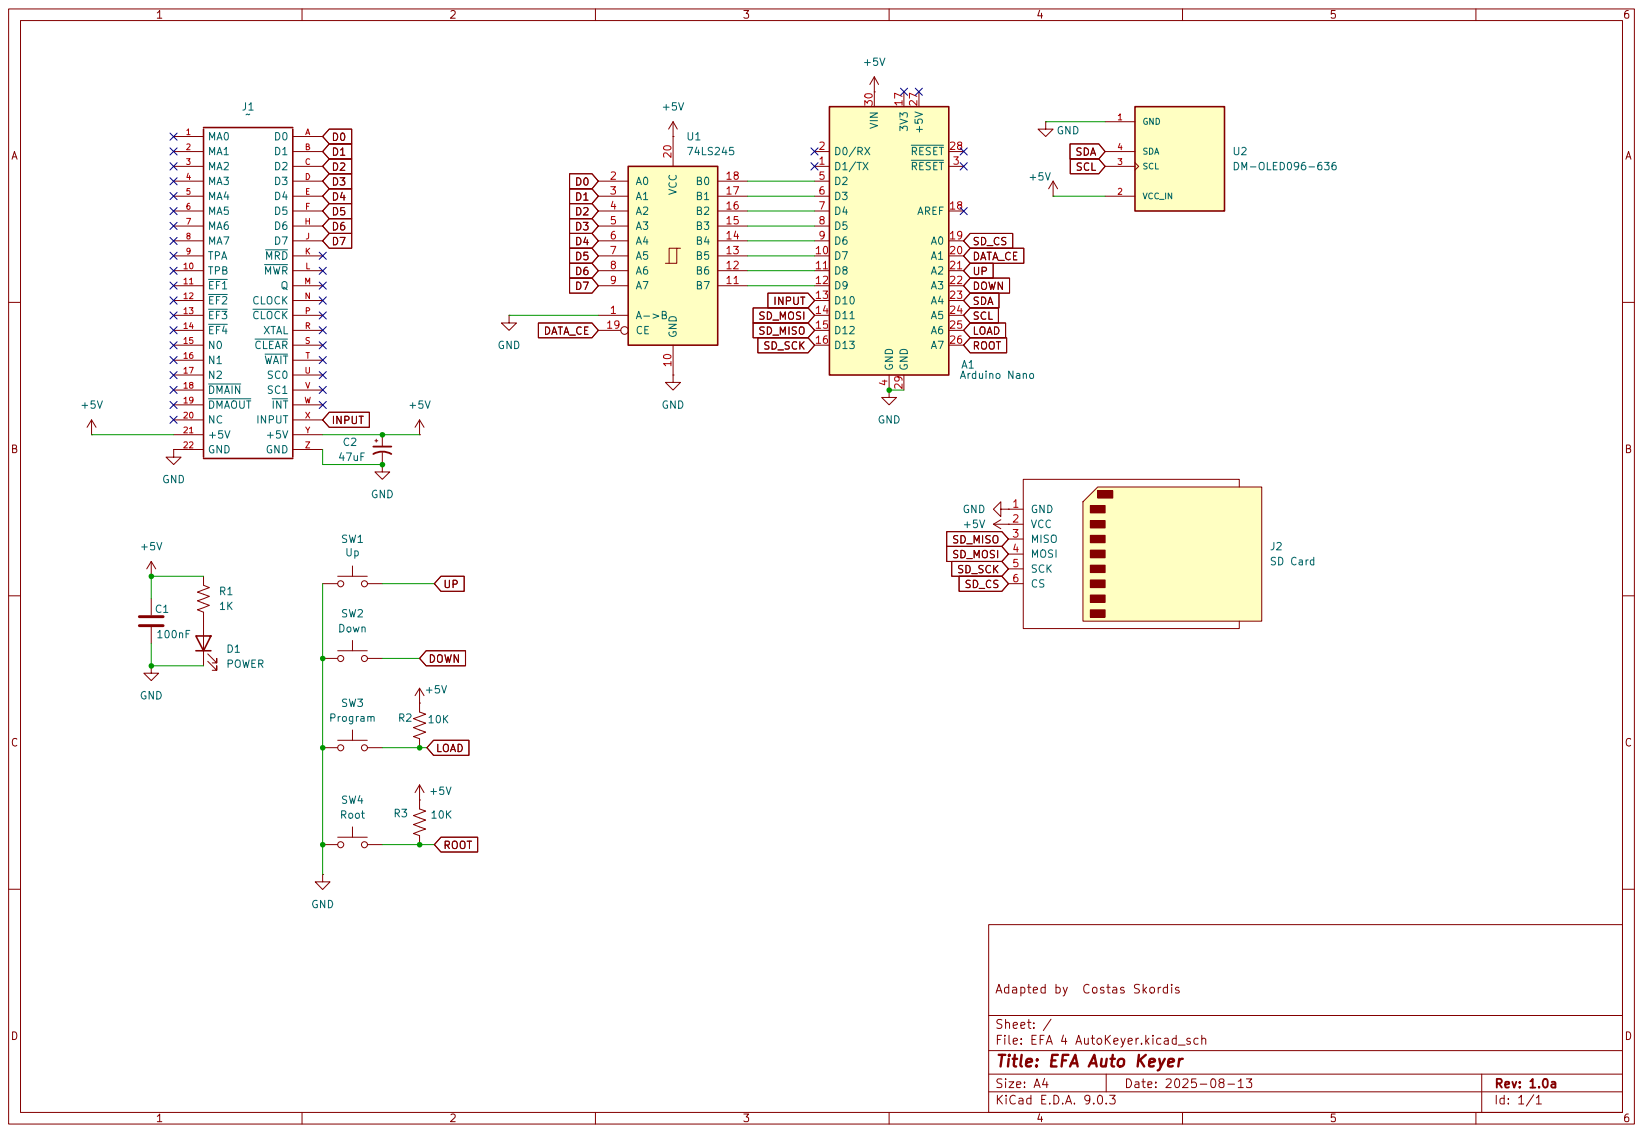
[picture p31: page 1]
