cskordis/EFA-datorn-EFA-4-Computer/EFA-4 Auto Keyer/Firmware/userconfig.h

/////////////////////////////////////////////////////////////////
/*                                                             */
/*                                                             */
/*          Configure your screen settings here                */
/*                                                             */
/*                                                             */
/////////////////////////////////////////////////////////////////


#define VERSION "EFA 4 Auto Key"
#define OLED1306      1            /* Defines if you are using a 128x64 or 128x32 OLED screen */
#define SerialDebug   1            /* Enable Serial debug */
#define ScrollLogo    0            /* Scroll logo if defined and if set to 0 center logo or 0 - 8 to scroll right to left */ 
#define InvertInKey   1            /* Invert signal for inkey */
#define DataDelay     5            /* Delay for data */
#define InKeyDelay    10           /* Delay InKey pulse*/
