cskordis/EFA-datorn-EFA-4-Computer/(commit log)

2025-08-30 Update README.md
    Added more daughter boards
2025-09-01 Create EFA 4 Schematic.pdf
2025-09-01 Create EFA 4 AutoKeyer Schematic.pdf
2025-09-01 Create EFA4Loader.ino
    Arduino code
2025-09-01 Create EFA 4 Backplane Board iBOM.html
2025-09-01 Create EFA 4 Backplane Board.pdf
2025-09-01 Create EFA 4 Backplane Board.zip
    PCB build files
2025-09-01 Create EFA 4 Backplane Board Solder Side.jpg
2025-09-01 Create EFA 4 Blank Board.zip
2025-09-01 Create EFA 4 Blank Board Component Side.jpg
2025-09-01 Create Gerbers
2025-09-01 Create EFA 4 Blank Board Schematic.pdf
2025-09-01 Updated content
    [EFA 4 Backplane Board.csv]
2025-09-01 Updated Ram Board
    [EFA 4 Ram Board BOM.csv]
2025-09-02 Update silkscreen
2025-09-05 Update gerber with disable speaker to ground
2025-09-05 Update schematic with disable speaker to ground
2025-09-05 Update to include disable speaker to ground
    [EFA 4 Keypad Input.csv]
2025-09-09 Update for version 1.0b
    [EFA 4 Backplane Board.csv, EFA 4 Hex Display Board BOM.csv]
2025-09-10 Update R46 from 470 Ohms to 2.2 K Ohms
    Update R46 from 470 Ohms to 2.2 KOhms
    Some 74LS00 brands do not oscillate coirrectly with R46 as 470 Ohms
    National Semiconductors DM74LS00 can be used wiuth either values.
    [EFA 4 BOM.csv]
